ThoNiklas/Media-Macroboard/Media-Macroboard/Media-Macroboard.pdf

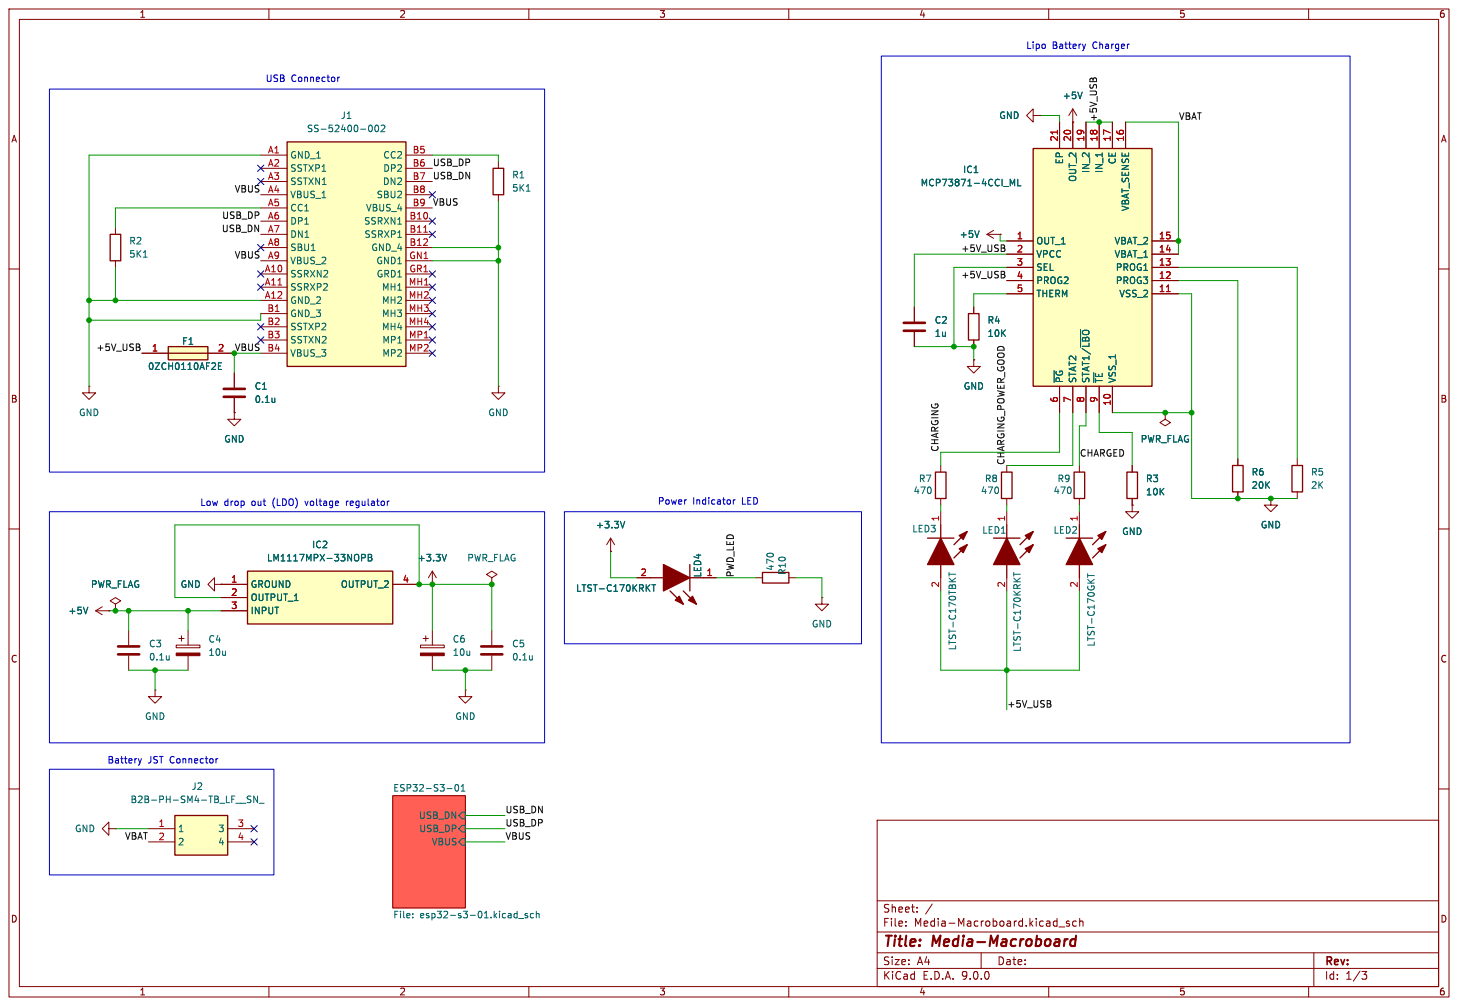
[picture p1: page 1]

7 IN_2 19 STAT1/~{LBO} 8 IN_1 18 ~{TE} 9 CE 17 VSS_1 10 VBAT_SENSE 16 VBAT_2 15 VBAT_1 14 PROG1 13 PROG3 12 VSS_2 11 GND

Battery JST Connector Low drop out (LDO) voltage regulator

Id: 1/3 Title: Media-Macroboard

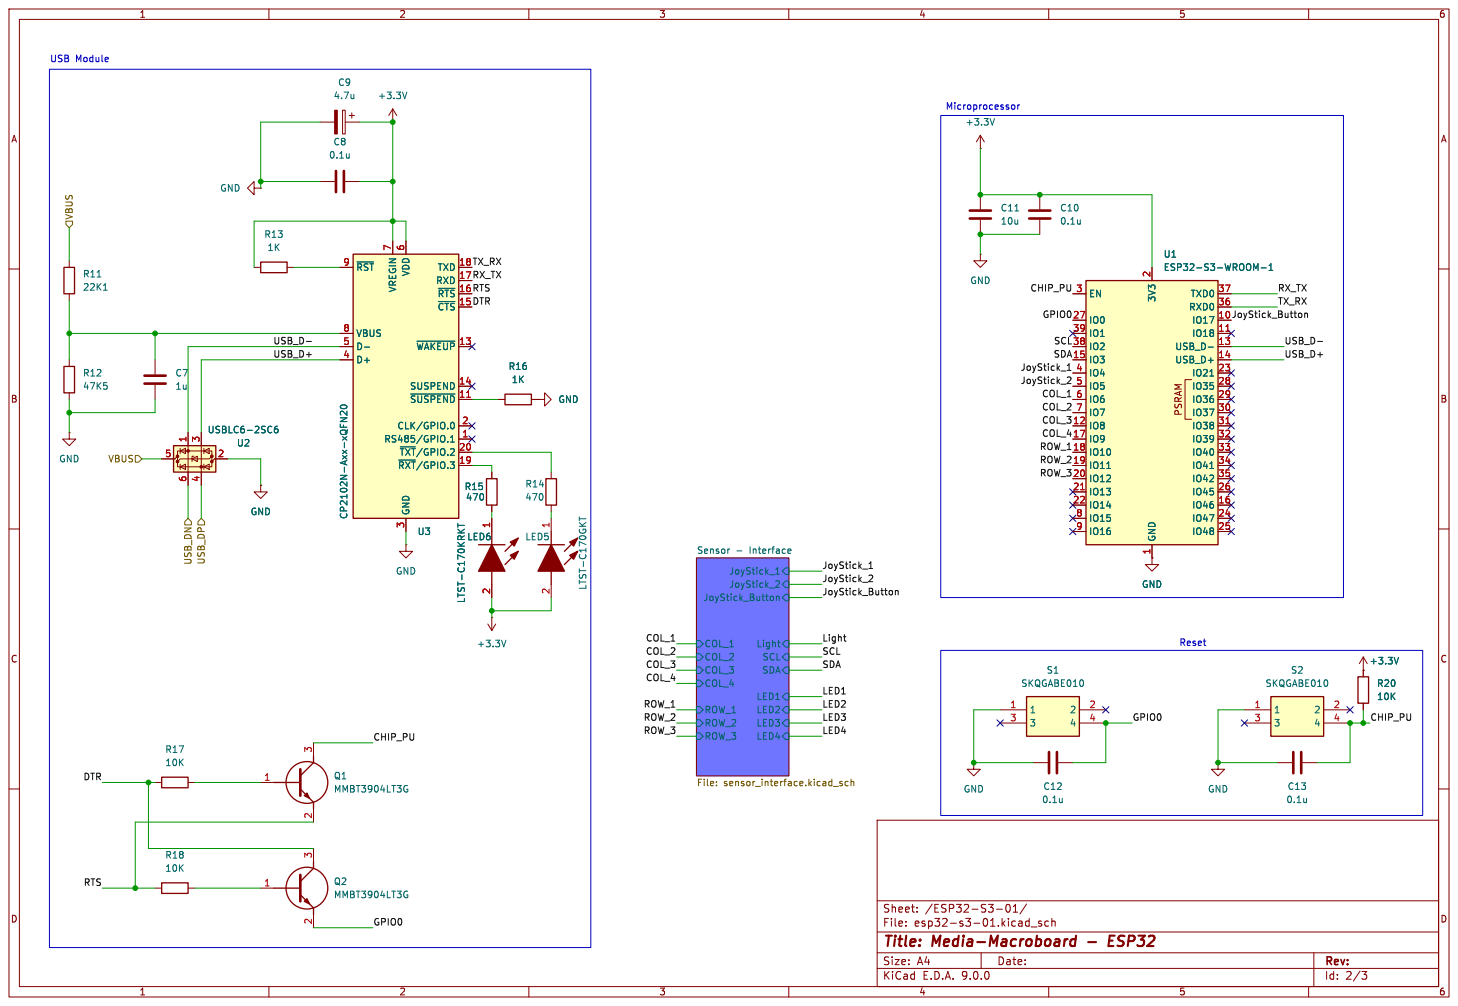
[picture p2: page 2]

3 TXD 18 RXD 17 ~{RTS} 16 ~{CTS} 15 ~{WAKEUP} 13 SUSPEND 14 ~{SUSPEND}11 CLK/GPIO.0 2 RS485/GPIO.1 1 ~{TXT}/GPIO.220 ~{RXT}/GPIO.319 U3 CP2102N-Axx-xQFN20 R16

3 TXD 18 RXD 17 ~{RTS} 16 ~{CTS} 15 ~{WAKEUP} 13 SUSPEND 14 ~{SUSPEND}11 CLK/GPIO.0 2 RS485/GPIO.1 1 ~{TXT}/GPIO.220 ~{RXT}/GPIO.319 R16

JoyStick_Button Sensor - Interface File: sensor_interface.kicad_sch GND

File: esp32-s3-01.kicad_sch Sheet: /ESP32-S3-01/ Light SCL SDA COL_1 COL_2 COL_3 COL_4 ROW_1 ROW_2 ROW_3

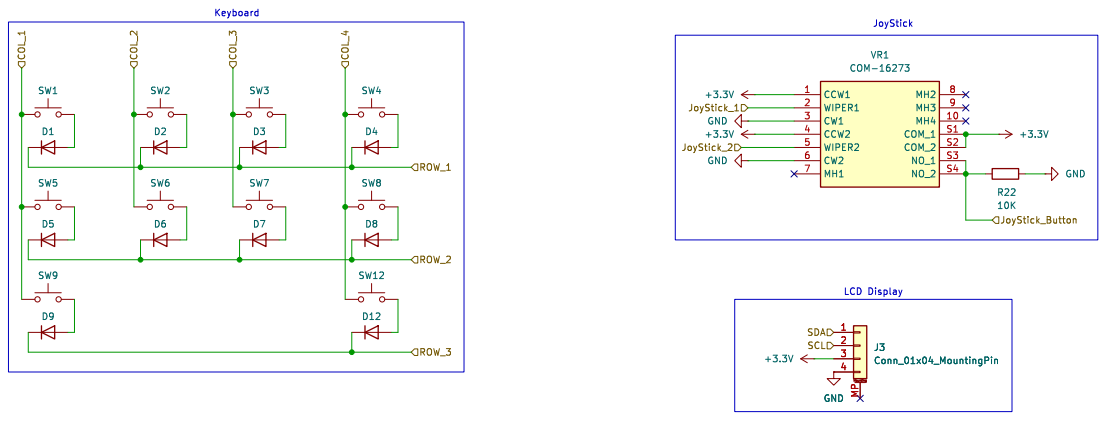
[picture p3: page 3]
