ThoNiklas/Media-Macroboard/Media-Macroboard/Media-Macroboard.kicad_pcb

## KiCad design Media-Macroboard/Media-Macroboard.kicad_pcb (2025-04-17)

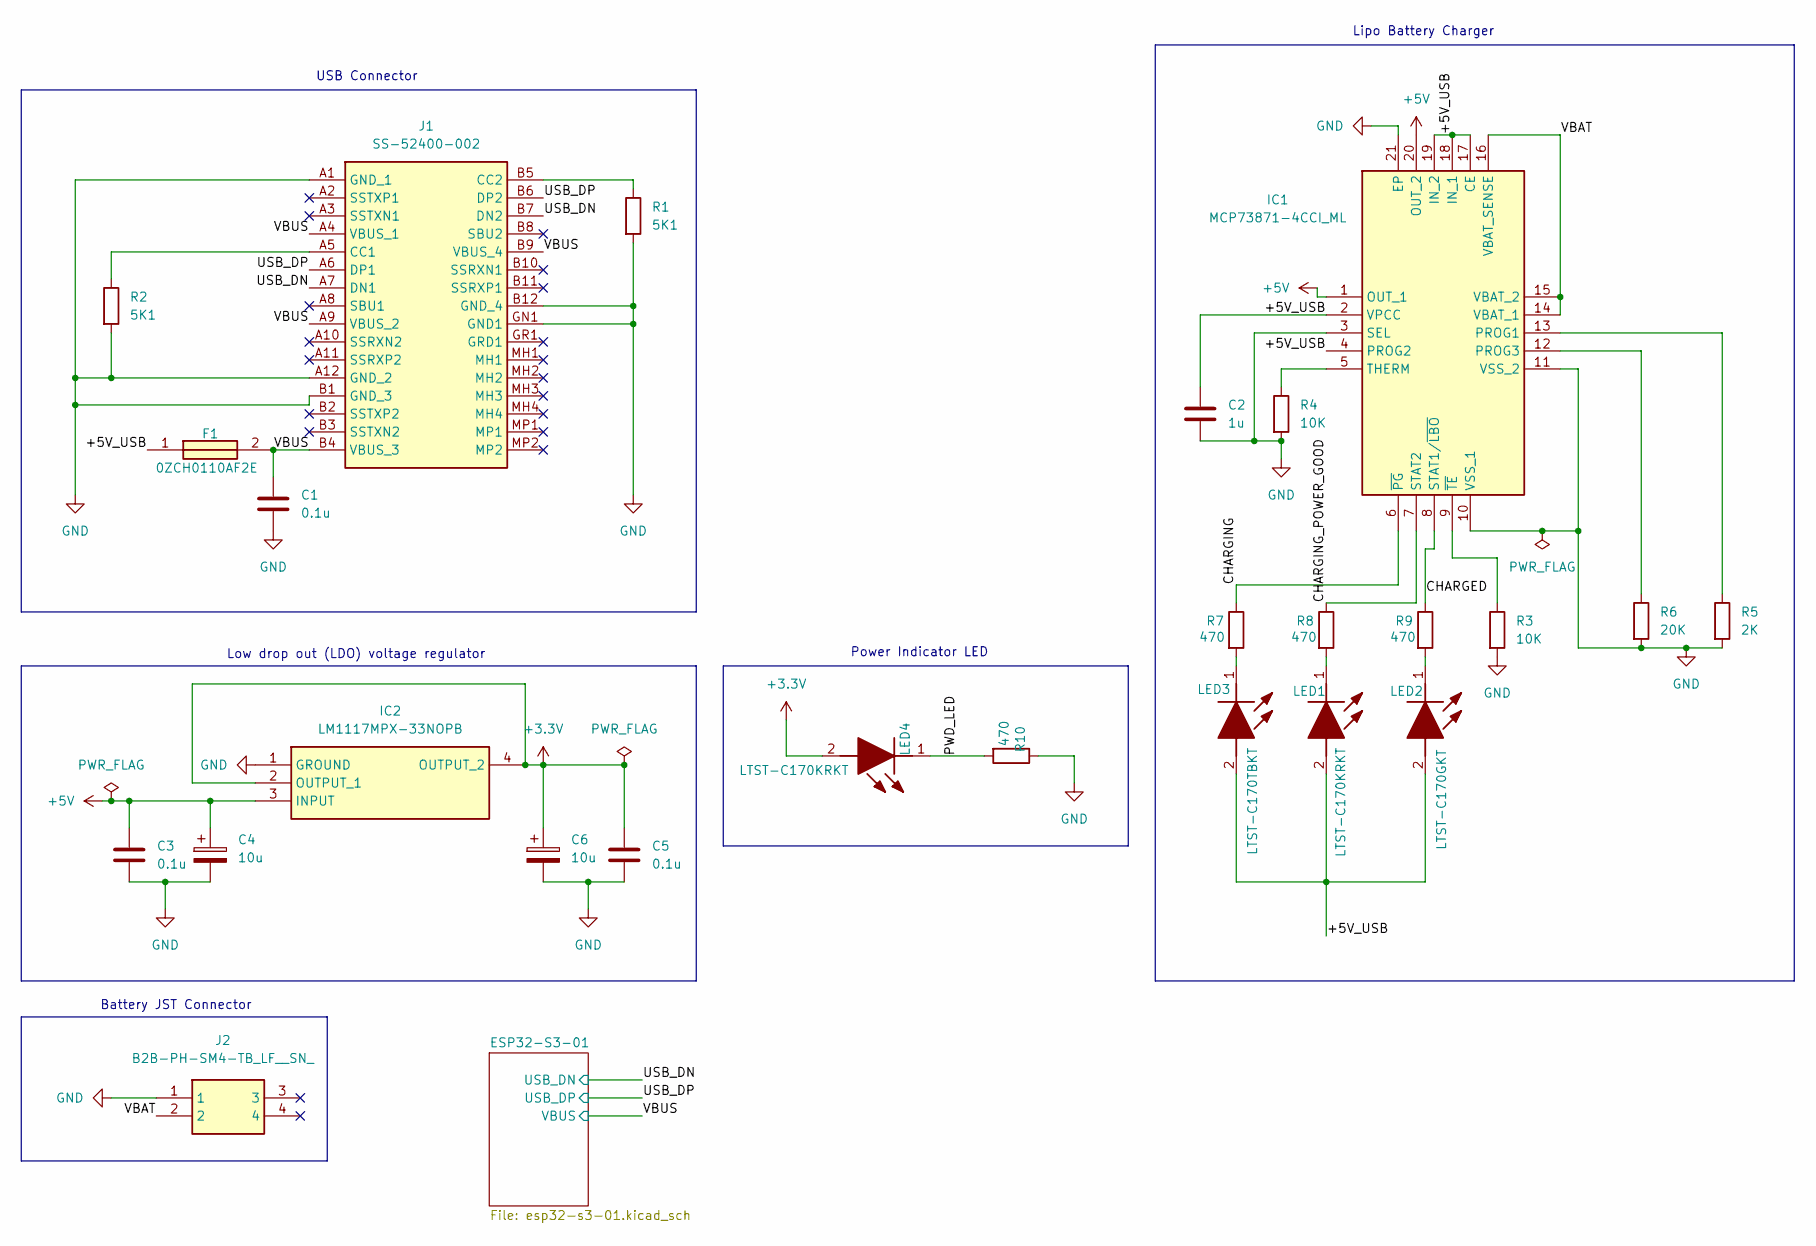
[picture p4: schematic Media-Macroboard.kicad_sch]

Parts:
C1, C3, C5: 0.1u; C_0805_2012Metric_Pad1.18x1.45mm_HandSolder
C2: 1u; C_0805_2012Metric_Pad1.18x1.45mm_HandSolder
C4, C6: 10u; C_1206_3216Metric
F1: 0ZCH0110AF2E; FUSC3226X100N; Manufacturer_Part_Number 0ZCH0110AF2E
IC1: MCP73871-4CCI_ML; QFN50P400X400X100-21N-D; Mouser Part Number 579-MCP73871-4CCI/ML
IC2: LM1117MPX-33NOPB; SOT230P700X180-4N; Mouser Part Number 863-LM1117MPX-33NOPB
J1: SS-52400-002; SS52400002; Mouser Part Number 530-SS-52400-002
J2: B2B-PH-SM4-TB_LF__SN_; B2BPHSM4TBLFSN; Mouser Part Number N/A
LED1, LED4: LTST-C170KRKT; LEDC2012X120N; Mouser Part Number 859-LTST-C170KRKT
LED2: LTST-C170GKT; LEDC2012X120N; Mouser Part Number 859-LTST-C170GKT
LED3: LTST-C170TBKT; LEDC2012X120N; Mouser Part Number 859-LTST-C170TBKT
R1, R2: 5K1; R_0805_2012Metric_Pad1.20x1.40mm_HandSolder
R3, R4: 10K; R_0805_2012Metric_Pad1.20x1.40mm_HandSolder
R5: 2K; R_0805_2012Metric_Pad1.20x1.40mm_HandSolder
R6: 20K; R_0805_2012Metric_Pad1.20x1.40mm_HandSolder
R7, R8, R9, R10: 470; R_0805_2012Metric_Pad1.20x1.40mm_HandSolder

Connections:
+3.3V: C5.1, C6.1, IC2.2 (OUTPUT_1), IC2.4 (OUTPUT_2), LED4.2 (A); also elsewhere on the board
+5V: C3.1, C4.1, IC1.1 (OUT_1), IC1.20 (OUT_2), IC2.3 (INPUT)
/+5V_USB: C2.1, F1.1, IC1.2 (VPCC), IC1.4 (PROG2), IC1.17 (CE), IC1.18 (IN_1), IC1.19 (IN_2), LED1.2 (A), LED2.2 (A), LED3.2 (A)
/CHARGED: IC1.8 (STAT1/~LBO), R9.1
/CHARGING: IC1.6 (~PG), R7.1
/CHARGING_POWER_GOOD: IC1.7 (STAT2), R8.1
/PWD_LED: LED4.1 (K), R10.2
/USB_DN: J1.A7 (DN1), J1.B7 (DN2); also elsewhere on the board
/USB_DP: J1.A6 (DP1), J1.B6 (DP2); also elsewhere on the board
/VBAT: IC1.14 (VBAT_1), IC1.15 (VBAT_2), IC1.16 (VBAT_SENSE), J2.2
/VBUS: C1.1, F1.2, J1.A4 (VBUS_1), J1.A9 (VBUS_2), J1.B4 (VBUS_3), J1.B9 (VBUS_4); also elsewhere on the board
GND: C1.2, C2.2, C3.2, C4.2, C5.2, C6.2, IC1.3 (SEL), IC1.10 (VSS_1), IC1.11 (VSS_2), IC1.21 (EP), IC2.1 (GROUND), J1.A1 (GND_1), J1.A12 (GND_2), J1.B1 (GND_3), J1.B12 (GND_4), J1.GN1 (GND1), J2.1, R1.2, R2.2, R3.2, R4.2, R5.2, R6.2, R10.1; also elsewhere on the board
unnamed: IC1.13 (PROG1), R5.1
unnamed: IC1.12 (PROG3), R6.1
unnamed: IC1.5 (THERM), R4.1
unnamed: IC1.9 (~TE), R3.1
unnamed: J1.A5 (CC1), R2.1
unnamed: J1.B5 (CC2), R1.1
unnamed: LED1.1 (K), R8.2
unnamed: LED2.1 (K), R9.2
unnamed: LED3.1 (K), R7.2

Notes on the sheet:
USB Connector
Lipo Battery Charger
Power Indicator LED
Battery JST Connector
Low drop out (LDO) voltage regulator

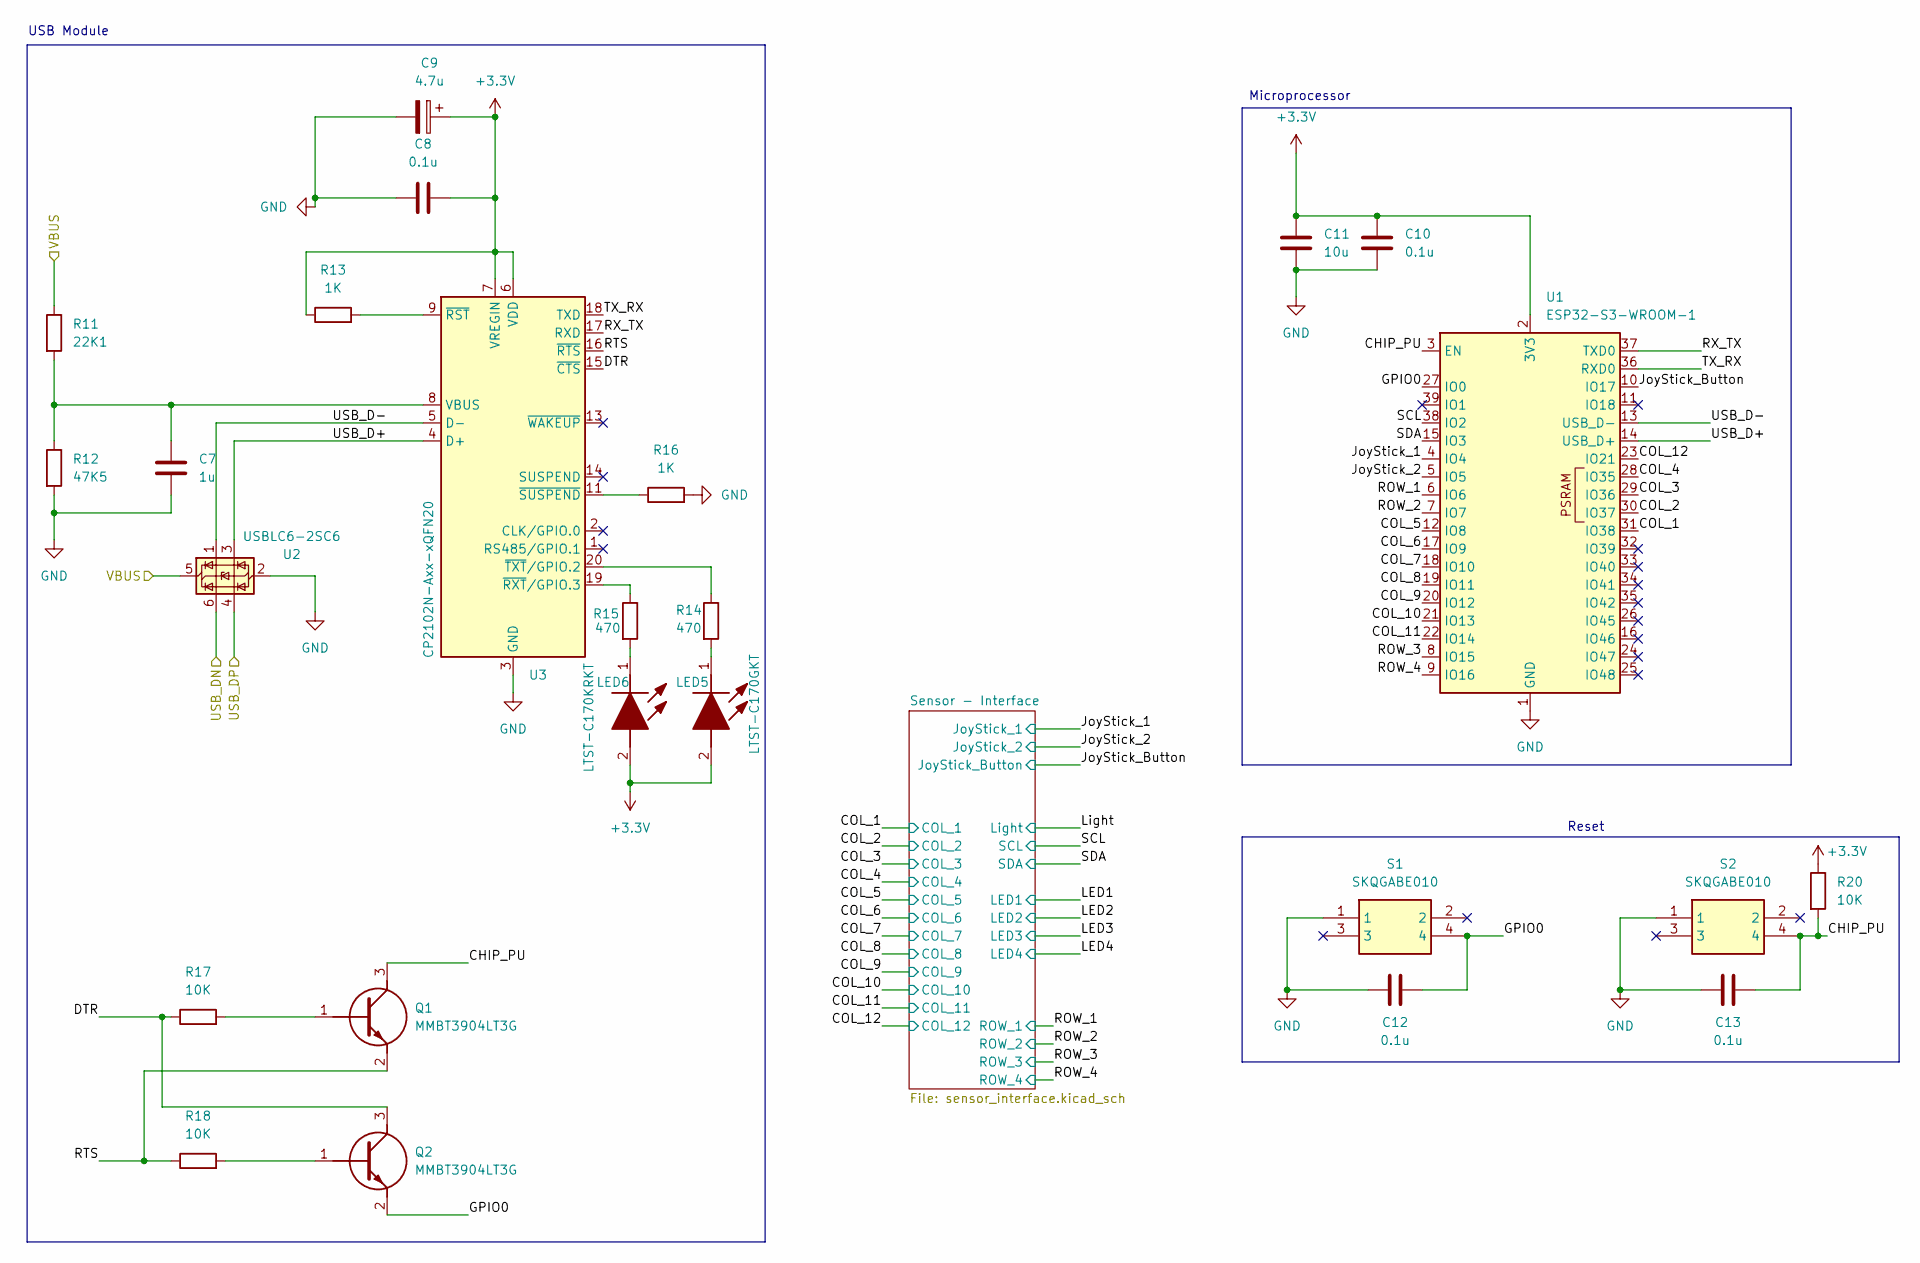
[picture p5: schematic esp32-s3-01.kicad_sch, Media-Macroboard - ESP32]

Parts:
C7: 1u; C_0805_2012Metric_Pad1.18x1.45mm_HandSolder
C8, C10, C12, C13: 0.1u; C_0805_2012Metric_Pad1.18x1.45mm_HandSolder
C9: 4.7u; C_1206_3216Metric
C11: 10u; C_0805_2012Metric_Pad1.18x1.45mm_HandSolder
LED5: LTST-C170GKT; LEDC2012X120N; Mouser Part Number 859-LTST-C170GKT
LED6: LTST-C170KRKT; LEDC2012X120N; Mouser Part Number 859-LTST-C170KRKT
Q1, Q2: MMBT3904LT3G; SOT96P237X111-3N; Mouser Part Number 863-MMBT3904LT3G
R11: 22K1; R_0805_2012Metric_Pad1.20x1.40mm_HandSolder
R12: 47K5; R_0805_2012Metric_Pad1.20x1.40mm_HandSolder
R13, R16: 1K; R_0805_2012Metric_Pad1.20x1.40mm_HandSolder
R14, R15: 470; R_0805_2012Metric_Pad1.20x1.40mm_HandSolder
R17, R18, R20: 10K; R_0805_2012Metric_Pad1.20x1.40mm_HandSolder
S1, S2: SKQGABE010; SKQGAKE010; Mouser Part Number 688-SKQGAB
U1: ESP32-S3-WROOM-1
U2: USBLC6-2SC6; SOT-23-6
U3: CP2102N-Axx-xQFN20; CP2102NA02GQFN20

Connections:
+3.3V: C8.2, C9.1, C10.1, C11.1, LED5.2 (A), LED6.2 (A), R13.1, R20.1, U1.2 (3V3), U3.6 (VDD), U3.7 (VREGIN); also elsewhere on the board
/ESP32-S3-01/CHIP_PU: C13.1, Q1.3 (C), R20.2, S2.4, U1.3 (EN)
/ESP32-S3-01/COL_1: U1.31 (IO38); also elsewhere on the board
/ESP32-S3-01/COL_2: U1.30 (IO37); also elsewhere on the board
/ESP32-S3-01/COL_3: U1.29 (IO36); also elsewhere on the board
/ESP32-S3-01/COL_4: U1.28 (IO35); also elsewhere on the board
/ESP32-S3-01/COL_5: U1.12 (IO8); also elsewhere on the board
/ESP32-S3-01/COL_6: U1.17 (IO9); also elsewhere on the board
/ESP32-S3-01/COL_7: U1.18 (IO10); also elsewhere on the board
/ESP32-S3-01/COL_8: U1.19 (IO11); also elsewhere on the board
/ESP32-S3-01/COL_9: U1.20 (IO12); also elsewhere on the board
/ESP32-S3-01/COL_10: U1.21 (IO13); also elsewhere on the board
/ESP32-S3-01/COL_11: U1.22 (IO14); also elsewhere on the board
/ESP32-S3-01/COL_12: U1.23 (IO21); also elsewhere on the board
/ESP32-S3-01/DTR: Q2.3 (C), R17.1, U3.15 (~CTS)
/ESP32-S3-01/GPIO0: C12.1, Q2.2 (E), S1.4, U1.27 (IO0)
/ESP32-S3-01/JoyStick_1: U1.4 (IO4); also elsewhere on the board
/ESP32-S3-01/JoyStick_2: U1.5 (IO5); also elsewhere on the board
/ESP32-S3-01/JoyStick_Button: U1.10 (IO17); also elsewhere on the board
/ESP32-S3-01/ROW_1: U1.6 (IO6); also elsewhere on the board
/ESP32-S3-01/ROW_2: U1.7 (IO7); also elsewhere on the board
/ESP32-S3-01/ROW_3: U1.8 (IO15); also elsewhere on the board
/ESP32-S3-01/ROW_4: U1.9 (IO16); also elsewhere on the board
/ESP32-S3-01/RTS: Q1.2 (E), R18.1, U3.16 (~RTS)
/ESP32-S3-01/RX_TX: U1.37 (TXD0), U3.17 (RXD)
/ESP32-S3-01/SCL: U1.38 (IO2); also elsewhere on the board
/ESP32-S3-01/SDA: U1.15 (IO3); also elsewhere on the board
/ESP32-S3-01/TX_RX: U1.36 (RXD0), U3.18 (TXD)
/ESP32-S3-01/USB_D+: U1.14 (USB_D+), U2.3 (I/O2), U3.4 (D+)
/ESP32-S3-01/USB_D-: U1.13 (USB_D-), U2.1 (I/O1), U3.5 (D-)
/USB_DN: U2.6 (I/O1); also elsewhere on the board
/USB_DP: U2.4 (I/O2); also elsewhere on the board
/VBUS: R11.1, U2.5 (VBUS); also elsewhere on the board
GND: C7.2, C8.1, C9.2, C10.2, C11.2, C12.2, C13.2, R12.2, R16.2, S1.1, S2.1, U1.1 (GND), U1.40 (GND), U1.41 (GND), U2.2 (GND), U3.3 (GND), U3.12 (GND), U3.21 (GND); also elsewhere on the board
unnamed: LED5.1 (K), R14.2
unnamed: LED6.1 (K), R15.2
unnamed: Q1.1 (B), R17.2
unnamed: Q2.1 (B), R18.2
unnamed: C7.1, R11.2, R12.1, U3.8 (VBUS)
unnamed: R13.2, U3.9 (~RST)
unnamed: R15.1, U3.19 (~RXT/GPIO.3)
unnamed: R16.1, U3.11 (~SUSPEND)
unnamed: R14.1, U3.20 (~TXT/GPIO.2)

Notes on the sheet:
Microprocessor
Reset
USB Module

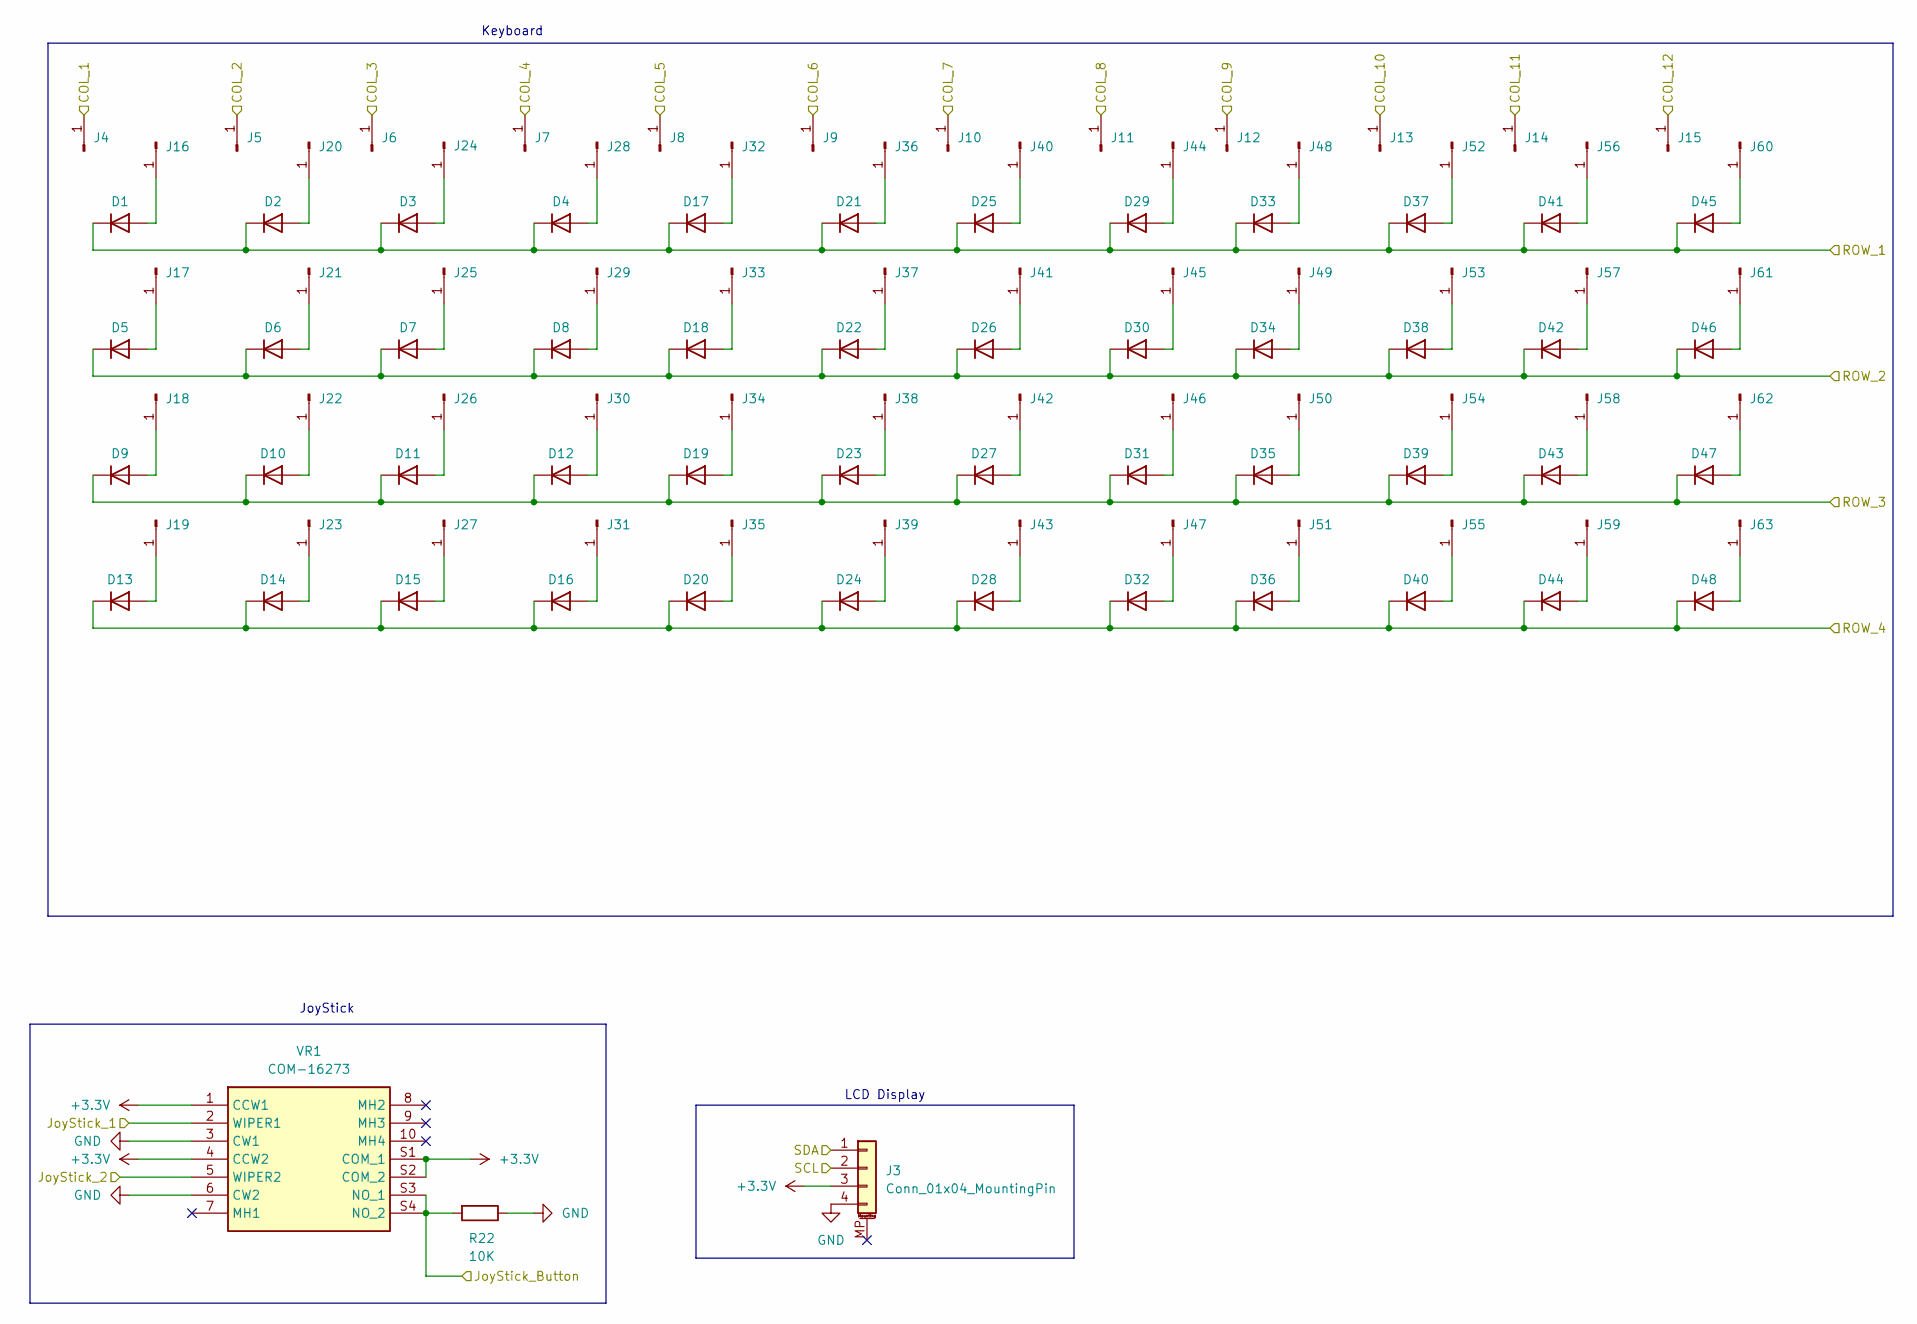
[picture p6: schematic sensor_interface.kicad_sch, Media-Macroboard - Sensor - Interface]

Parts:
D1, D2, D3, D4, D5, D6, D7, D8, D9, D10, D11, D12, D13, D14, D15, D16, D17, D18, D19, D20, D21, D22, D23, D24, D25, D26, D27, D28, D29, D30, D31, D32, D33, D34, D35, D36, D37, D38, D39, D40, D41, D42, D43, D44, D45, D46, D47, D48: D; D_0805_2012Metric_Pad1.15x1.40mm_HandSolder
J3: Conn_01x04_MountingPin; PinHeader_1x04_P2.54mm_Vertical
J4, J5, J6, J7, J8, J9, J10, J11, J12, J13, J14, J15, J16, J17, J18, J19, J20, J21, J22, J23, J24, J25, J26, J27, J28, J29, J30, J31, J32, J33, J34, J35, J36, J37, J38, J39, J40, J41, J42, J43, J44, J45, J46, J47, J48, J49, J50, J51, J52, J53, J54, J55, J56, J57, J58, J59, J60, J61, J62, J63: Conn_01x01_Pin; PinHeader_1x01_P1.00mm_Vertical
R22: 10K; R_0805_2012Metric_Pad1.20x1.40mm_HandSolder
VR1: COM-16273; COM16273; Mouser Part Number 474-COM-16273

Connections:
+3.3V: J3.3, VR1.1 (CCW1), VR1.4 (CCW2), VR1.S1 (COM_1), VR1.S2 (COM_2); also elsewhere on the board
/ESP32-S3-01/COL_1: J4.1; also elsewhere on the board
/ESP32-S3-01/COL_2: J5.1; also elsewhere on the board
/ESP32-S3-01/COL_3: J6.1; also elsewhere on the board
/ESP32-S3-01/COL_4: J7.1; also elsewhere on the board
/ESP32-S3-01/COL_5: J8.1; also elsewhere on the board
/ESP32-S3-01/COL_6: J9.1; also elsewhere on the board
/ESP32-S3-01/COL_7: J10.1; also elsewhere on the board
/ESP32-S3-01/COL_8: J11.1; also elsewhere on the board
/ESP32-S3-01/COL_9: J12.1; also elsewhere on the board
/ESP32-S3-01/COL_10: J13.1; also elsewhere on the board
/ESP32-S3-01/COL_11: J14.1; also elsewhere on the board
/ESP32-S3-01/COL_12: J15.1; also elsewhere on the board
/ESP32-S3-01/JoyStick_1: VR1.2 (WIPER1); also elsewhere on the board
/ESP32-S3-01/JoyStick_2: VR1.5 (WIPER2); also elsewhere on the board
/ESP32-S3-01/JoyStick_Button: R22.2, VR1.S3 (NO_1), VR1.S4 (NO_2); also elsewhere on the board
/ESP32-S3-01/ROW_1: D1.1 (K), D2.1 (K), D3.1 (K), D4.1 (K), D17.1 (K), D21.1 (K), D25.1 (K), D29.1 (K), D33.1 (K), D37.1 (K), D41.1 (K), D45.1 (K); also elsewhere on the board
/ESP32-S3-01/ROW_2: D5.1 (K), D6.1 (K), D7.1 (K), D8.1 (K), D18.1 (K), D22.1 (K), D26.1 (K), D30.1 (K), D34.1 (K), D38.1 (K), D42.1 (K), D46.1 (K); also elsewhere on the board
/ESP32-S3-01/ROW_3: D9.1 (K), D10.1 (K), D11.1 (K), D12.1 (K), D19.1 (K), D23.1 (K), D27.1 (K), D31.1 (K), D35.1 (K), D39.1 (K), D43.1 (K), D47.1 (K); also elsewhere on the board
/ESP32-S3-01/ROW_4: D13.1 (K), D14.1 (K), D15.1 (K), D16.1 (K), D20.1 (K), D24.1 (K), D28.1 (K), D32.1 (K), D36.1 (K), D40.1 (K), D44.1 (K), D48.1 (K); also elsewhere on the board
/ESP32-S3-01/SCL: J3.2; also elsewhere on the board
/ESP32-S3-01/SDA: J3.1; also elsewhere on the board
GND: J3.4, R22.1, VR1.3 (CW1), VR1.6 (CW2); also elsewhere on the board
unnamed: D1.2 (A), J16.1
unnamed: D2.2 (A), J20.1
unnamed: D3.2 (A), J24.1
unnamed: D4.2 (A), J28.1
unnamed: D5.2 (A), J17.1
unnamed: D6.2 (A), J21.1
unnamed: D7.2 (A), J25.1
unnamed: D8.2 (A), J29.1
unnamed: D9.2 (A), J18.1
unnamed: D10.2 (A), J22.1
unnamed: D11.2 (A), J26.1
unnamed: D12.2 (A), J30.1
unnamed: D13.2 (A), J19.1
unnamed: D14.2 (A), J23.1
unnamed: D15.2 (A), J27.1
unnamed: D16.2 (A), J31.1
unnamed: D17.2 (A), J32.1
unnamed: D18.2 (A), J33.1
unnamed: D19.2 (A), J34.1
unnamed: D20.2 (A), J35.1
unnamed: D21.2 (A), J36.1
unnamed: D22.2 (A), J37.1
unnamed: D23.2 (A), J38.1
unnamed: D24.2 (A), J39.1
unnamed: D25.2 (A), J40.1
unnamed: D26.2 (A), J41.1
unnamed: D27.2 (A), J42.1
unnamed: D28.2 (A), J43.1
unnamed: D29.2 (A), J44.1
unnamed: D30.2 (A), J45.1
unnamed: D31.2 (A), J46.1
unnamed: D32.2 (A), J47.1
unnamed: D33.2 (A), J48.1
unnamed: D34.2 (A), J49.1
unnamed: D35.2 (A), J50.1
unnamed: D36.2 (A), J51.1
unnamed: D37.2 (A), J52.1
unnamed: D38.2 (A), J53.1
unnamed: D39.2 (A), J54.1
unnamed: D40.2 (A), J55.1
unnamed: D41.2 (A), J56.1
unnamed: D42.2 (A), J57.1
unnamed: D43.2 (A), J58.1
unnamed: D44.2 (A), J59.1
unnamed: D45.2 (A), J60.1
unnamed: D46.2 (A), J61.1
unnamed: D47.2 (A), J62.1
unnamed: D48.2 (A), J63.1

Notes on the sheet:
Keyboard
JoyStick
LCD Display

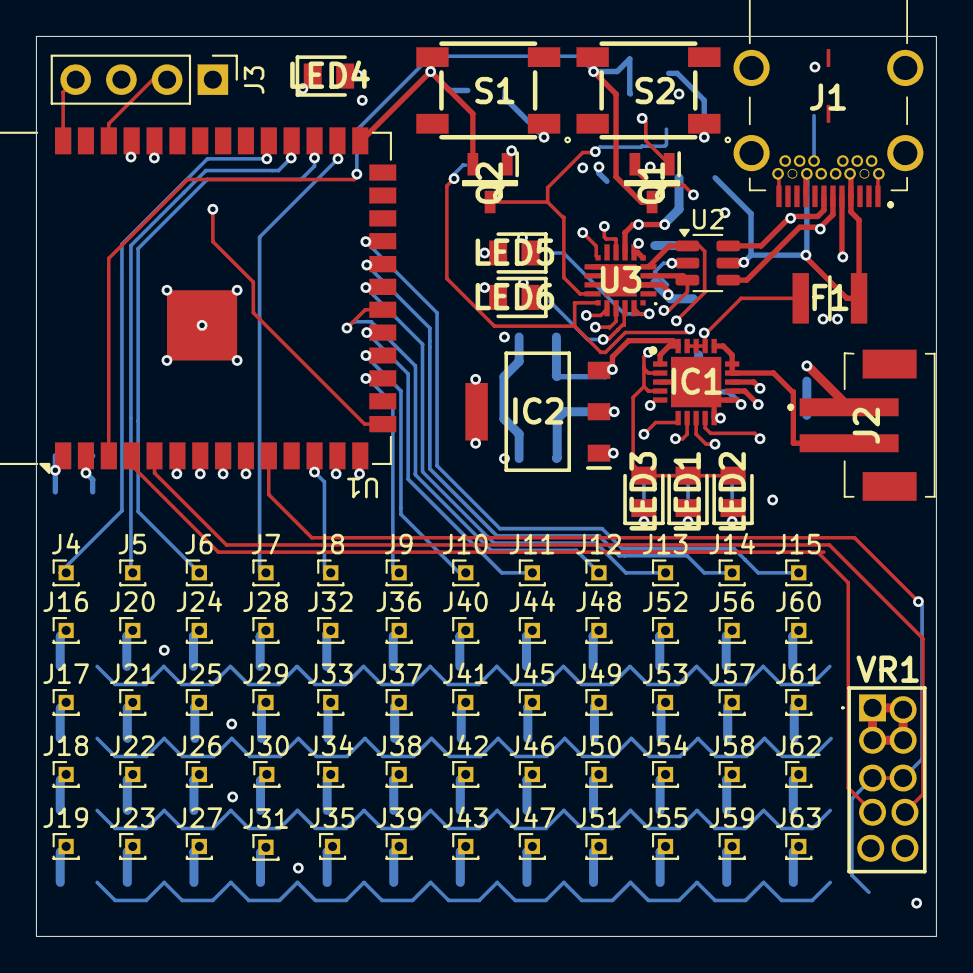
[picture p7: board Media-Macroboard.kicad_pcb from above]

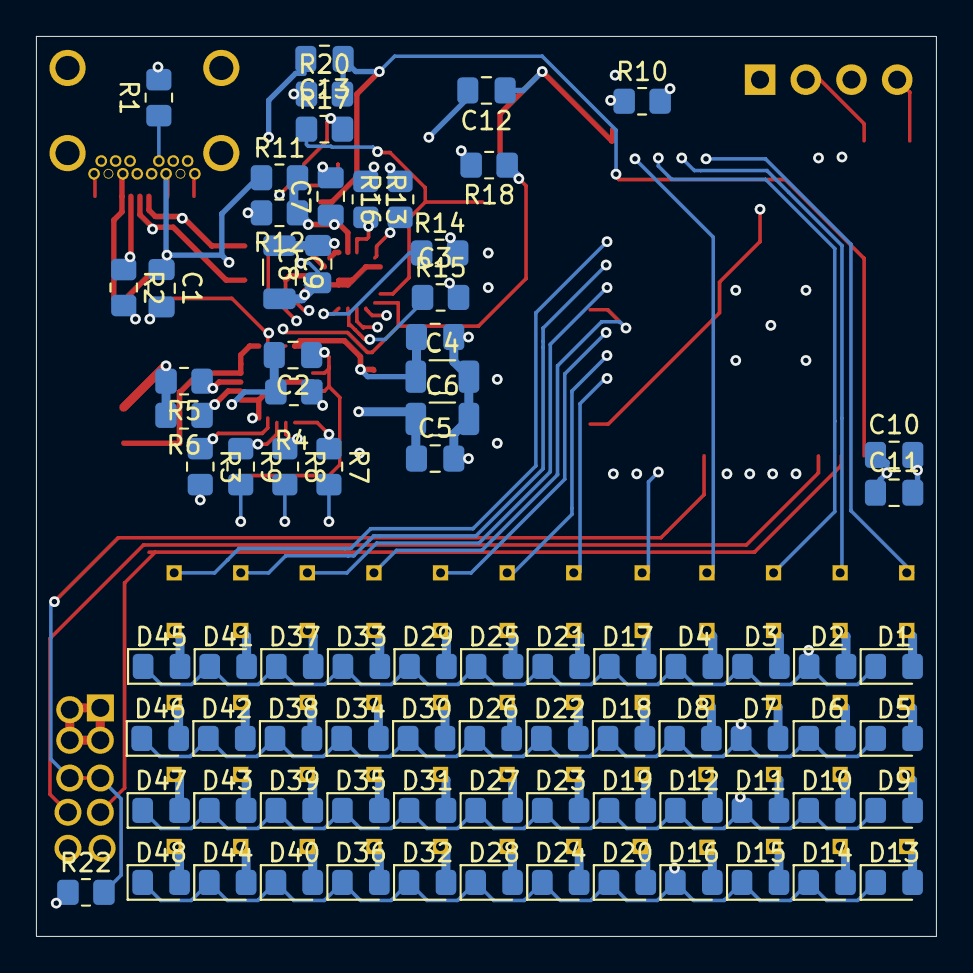
[picture p8: board Media-Macroboard.kicad_pcb from below]

Board: 4 copper layers, 50.0 x 50.0 mm, 161 parts (81 on the bottom side), 107 nets.
