ThoNiklas/Media-Macroboard/(commit log)

2025-03-23 First productable version
    [Media-Macroboard.kicad_pcb, Media-Macroboard.kicad_sch, esp32-s3-01.kicad_sch, sensor_interface.kicad_sch]
2025-04-12 Made four-layer version
    [Media-Macroboard.kicad_pcb, esp32-s3-01.kicad_sch, sensor_interface.kicad_sch]
2025-04-17 Added more rows and columns
    [Media-Macroboard.kicad_pcb, esp32-s3-01.kicad_sch, sensor_interface.kicad_sch]
